CCandle/arduino_robot_XJTU/README.md

# arduino_robot_XJTU

本仓库为西安交通大学*创新与机器人创客实践*课程实践小组的开发仓库

`remote` 与 `src` 目录下分别为遥控器和机内控制程序 Arduino 项目

`DevelopingFiles` 文件内含接线图纸与软件模拟代码
