CCandle/arduino_robot_XJTU/Report/report.tex

\documentclass[a4paper]{ctexart}
\usepackage{xeCJK}

\setCJKmainfont[BoldFont={方正大黑简体}, ItalicFont={方正盛世楷书简体_准}, BoldItalicFont={方正大标宋简体}]{方正标雅宋简体}
\setCJKsansfont{方正兰亭细黑简体}
\setCJKmonofont{仿宋}

\title{配重式全向球形机器人}
\author{码力全关组}

% Math
\usepackage{amsthm, amsmath, amssymb}
\usepackage{mathrsfs}
% Utility
\usepackage{graphicx}
\usepackage{subfigure}
\usepackage{lastpage}
% Beautifying packages
\usepackage{wallpaper}
% Code related
\usepackage{minted, framed}
\usepackage{listings}
\usepackage[linesnumbered,boxed]{algorithm2e}
% Formatting
\usepackage{footmisc}
\usepackage{float}
\usepackage{longtable, array, booktabs}
\usepackage{fancyhdr}
\usepackage{tcolorbox, framed}
\usepackage{geometry}
\usepackage{multicol}
%\usepackage[toc]{multitoc}
\usepackage{hyperref}
% tikz
\usepackage{xcolor}
\usepackage{tikz}
\usetikzlibrary{arrows,shapes,chains}

\tikzstyle{startstop}=[rectangle,rounded corners,minimum width=3cm,minimum height=1cm,text centered,draw=black,fill=red!30]
\tikzstyle{process}=[rectangle,minimum width=3cm,minimum height=1cm,text centered,text width =3cm,draw=black,fill=orange!30]
\tikzstyle{arrow}=[thick,->,>=stealth]

% Macro definitions
\usepackage{color}
\definecolor{grey}{RGB}{190, 190, 190}
\geometry{a4paper,left=2.8cm,right=2.8cm,top=3.2cm,bottom=3.2cm}
\newcommand{ \upcite}[1]{\textsuperscript{\textsuperscript{\cite{#1} } }}
\newcommand{ \mathbit}[1]{\mathbf{\mathit{#1}}}
\hypersetup{
colorlinks=true,
linkcolor=black
}
\numberwithin{equation}{section}
\numberwithin{table}{section}
\numberwithin{figure}{section}

\setlength{\columnseprule}{0.8pt}
\setlength\columnsep{1cm}

%%%%%%%%%%%%%%%%%%

\begin{document}
\setboolean{@twoside}{true}

\begin{titlepage}

  \maketitle
  \begin{center}
    小组课程实践
  \end{center}

  \ThisLRCornerWallPaper{0.8}{cover.png}

  \begin{center}
  \begin{tabular}[]{cccc}
  \toprule
  成员/分工 & 班级 & 姓名 & 联系电话\\
  \midrule
  组长 & 计算机试验班91 & 张骏扬 & 18967993817 \\
  执行组长 & 电类012 & 曲凌枫 & 15698207871 \\
  机械组 & 电气与信息003 & 马博楠 & 17693108836 \\
  电子组 & 计算机试验班001 & 栾家骏 & 13323022829 \\
  软件组 & 计算机试验班91 & 戴嘉琦 & 18612535164 \\
  \bottomrule
  \end{tabular}
\end{center}
  \addtocounter{table}{-1}

\begin{center}
  创新思维和机器人创客实践
\end{center}

\thispagestyle{empty}

\end{titlepage}

\addtocounter{page}{-2}

\newpage

\thispagestyle{fancy}
\lhead{}
\chead{\it\small{\textcolor{grey}{目录}}}
\rhead{}
\cfoot{}

\tableofcontents

\newpage

% now body
\pagestyle{fancy}
\fancyhead[RE, LO]{\it\small\rightmark}
\fancyhead[C]{\small{\it\textcolor{grey}{配重式球形机器人}}}
\fancyhead[LE, RO]{\it\small{马力全关组}}
\fancyfoot[C]{\it\small{第 \thepage 页\ 共 \pageref{LastPage} 页}}

\section{问题提出}

\subsection{设计背景与目的}

本组所建立的配重式全向球形机器人项目是西安交通大学课程“创新思维和机器人创客实践”的机器人小组实践项目。设计目的是：

\begin{itemize}
  \item 进行团队组织实践，使用团队组织技巧，锻炼合作能力；
  \item 进行产品调研与开发实践，锻炼创新能力；
  \item 进行机械、电子、软件设计实践，锻炼学习与设计能力；
  \item 进行系统统调装配，锻炼排错与优化能力。
\end{itemize}

球形机器人的应用包括监视、环境监测、巡视、水下探索、行星探索、复康、儿童发展及娱乐。球形机器人也可以是可以在陆地上或是水中（或水底）行动的两栖机器人。

\subsection{国内外现有研究成果}

最常见的球形机器人行动方式是透过调整机器人的重心位置来达到\upcite{halme1996motion}。其他的行动方式有利用飞轮的角动量守恒\upcite{joshi2010design}、利用环境中的风、利用外壳形变的方式移动、以及用陀螺仪效应。

配重式全向球形机器人最初的设计概念在 2004 年被提出\upcite{2004Introducing}。

\section{需求分析}

\subsection{需求分析和筛选}

本项目拟实现的机器人分两类，一类是足式机器人，一类是球形机器人。本组最终选择了球形机器人，原因是，根据本项目锻炼设计与创新能力的目标，球形机器人应用较不成熟，有更大难度与发展空间，符合需求。

球形形态机器人可衡量的目标有以下几点：

\begin{itemize}
  \item 全向对称移动：在球形机器人的任何状态能够以任意方向继续滚动，使得在地面斜率变化的情况下可以使用算法保持稳定的运动路线；
  \item 精密控制能力：配重式球形机器人能够进行精密的位置操控；
  \item 通过性：同尺寸球形机器人相较其他形态拥有较强的通过性，适应不平整地形；
  \item 机械强度与密闭性：球形机器人可以使用无线控制方式，使得球壳能够完全密闭，防水抗干扰；
\end{itemize}

这些目标基本是可以同时达到的，但是均为设计阶段就决定的问题，并且样机一般无法做到机械强度等指标，只可能在精密控制指标下细化。这些指标考验了设计能力。

\section{设计概念生成、选择、评估与实现}

\subsection{概念的生成}

下面介绍本项目按时间阶段拟设计的四种机器人方案。

\subsubsection{设计概念一——六足式机器人}

最初，本项目拟设计制作六电机六足式模块化机器人，并使用该设想进行初步立项。该设想被否决，原因是已有成熟的商业产品先例以及开源项目，无法体现创新性。

\begin{figure}[H]
  \begin{center}
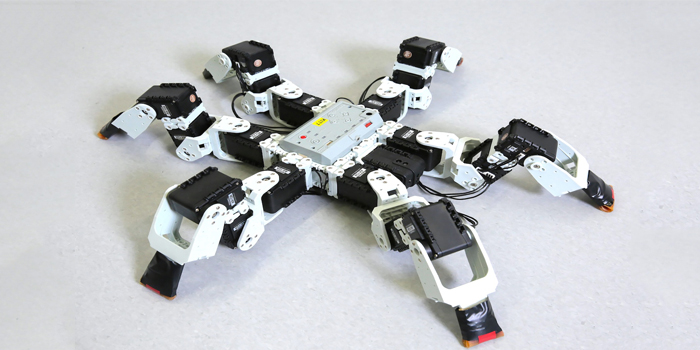
[picture p1: Report/figures/sixfeet.jpeg]
    
  \end{center}
  \label{fig_concept_1}
  \caption{设计概念目标设想图}
\end{figure}

本设计概念已经进展到查阅相关资料，尝试阅读控制逻辑的阶段。本设计概念提出尝试实行后立刻更改了设想。

\subsubsection{设计概念二——三足式弹跳机器人}

六足机器人否决后，本项目拟设计制作小型化三足式弹跳机器人。

该弹跳机器人通过电机压缩弹簧，随后释放锁止机构，使机器人进行不断运动。并通过不同的电机压缩程度控制弹跳方向。

\begin{figure}[H]
  \begin{center}
    
  \end{center}
  \label{fig_concept_2}
  \caption{设计概念二草图设计图}
\end{figure}

本设计概念已经进展到草图设想，控制系统拟设计的阶段。

然而在初步设计控制算法和电子系统后，发现短时间内的资源不足以使机器人达到轻量化，样机验证困难。因各种原因遂放弃该设计。

\subsubsection{设计概念三——重心牵拉式球形机器人}

由于三足式机器人的流产，本项目将方向转变为球形机器人。

\begin{figure}[H]
  \begin{center}
    
  \end{center}
  \label{fig_concept_3}
  \caption{设计概念三草图设计图}
\end{figure}

设计概念三是球形牵拉式配重机器人。正四面体球心的主体部分是控制结构与电机，同时作为配重改变球体的重心。四个线轴由电机控制，通过改变线的长度改变重心相对于几何中心的位置，利用重力矩使机器人运动。

该设计概念难以实现的原因是，线轴难以保证不滑动，且难以进行加工，遂否决。

\subsubsection{设计概念四——配重式球型机器人}

最终，在设计概念三的基础上，本项目设计了四组配重块形成的配重式球形机器人。具体设计见下文。

\subsection{概念选择与评估}

由上述设计概念历史，足型机器人不符合创新设计的要求，牵拉式机器人机械结构难以实现，于是选择配重式球形机器人。

\section{概念的具体设计}

\subsection{机械系统设计}

\begin{figure}[H]
  \begin{minipage}{0.32\linewidth}
    \begin{center}
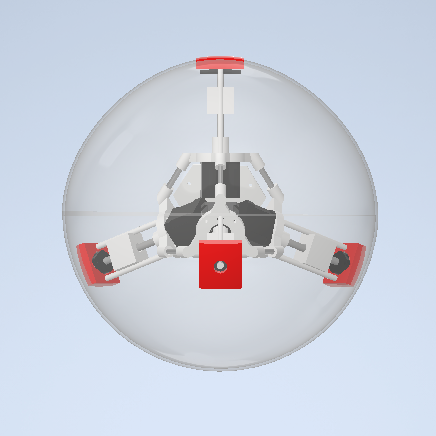
[picture p2: Report/figures/rendered1.png]
      
    \end{center}
  \end{minipage}
  \hfill
  \begin{minipage}{0.32\linewidth}
    \begin{center}
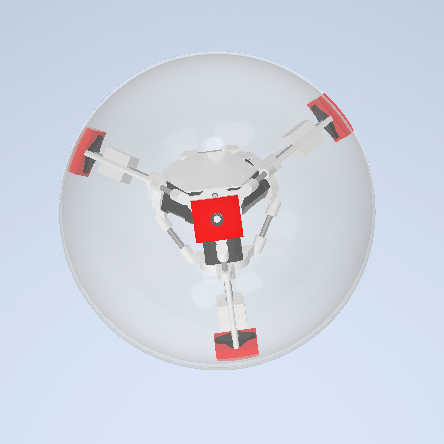
[picture p3: Report/figures/rendered2.png]
      
    \end{center}
  \end{minipage}
  \hfill
  \begin{minipage}{0.32\linewidth}
    \begin{center}
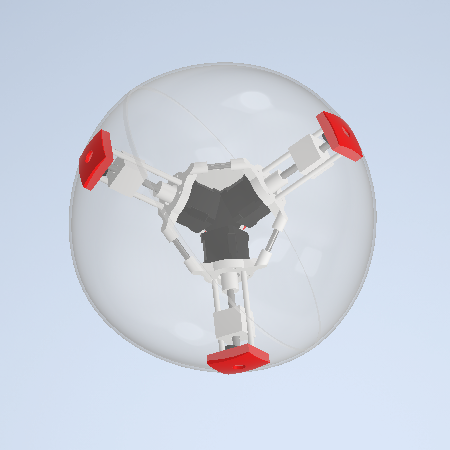
[picture p4: Report/figures/rendered3.png]
      
    \end{center}
  \end{minipage}
  \caption{机械结构 CAD 设计渲染图}
\end{figure}

该球形机器人以伊朗科技大学的 Puyan Mojabi 和伊朗加兹温阿萨德大学的 Amir Homayoun Javadi A 开发的一种全方位球形运动机器人 August\upcite{2004Introducing} 为原型进行设计，机器人主体分为核心框架，丝杆滑台，球壳三大部分。

其中核心框架为正四面体结构，四个顶角位置设计了连接角结构用于构建框架并固定步进电机。步进电机传动轴从连接角内侧身处并通过联轴器与丝杆滑台连接，滑台结构两侧的导轨在保证质量块正常运动的同时也加强了整个结构的强度。机器人内部结构通过自主设计的固定座与球壳连接，由于结构特性，连接处无需使用粘结剂固定，便于拆卸维修与调试。

机械系统各部件加工采用了不同的方法，其中注塑球壳、配重、丝杆滑台、轴承等部件为预制工业品，固定座与连接角结构框架为 3D 打印部件。电子部件的固定基座由亚克力切割完成。结构利用螺丝、无痕胶、扎带等方式固定，在保证开发效率的情况下照顾了机械强度等要求。

\subsection{电子系统设计}

\subsubsection{电子系统综述}

该机器人使用的电子系统围绕 Arduino UNO 控制板开发。图\ref{fig_elec}为遥控器系统和电子控制系统接线示意图，在实际实践中，还加入了电机电源开关等器件，便于调试与保护。

\begin{figure}[H]
  \centering
  \subfigure[机上电子系统接线图纸]{
    \label{fig_elec_subfig_a}
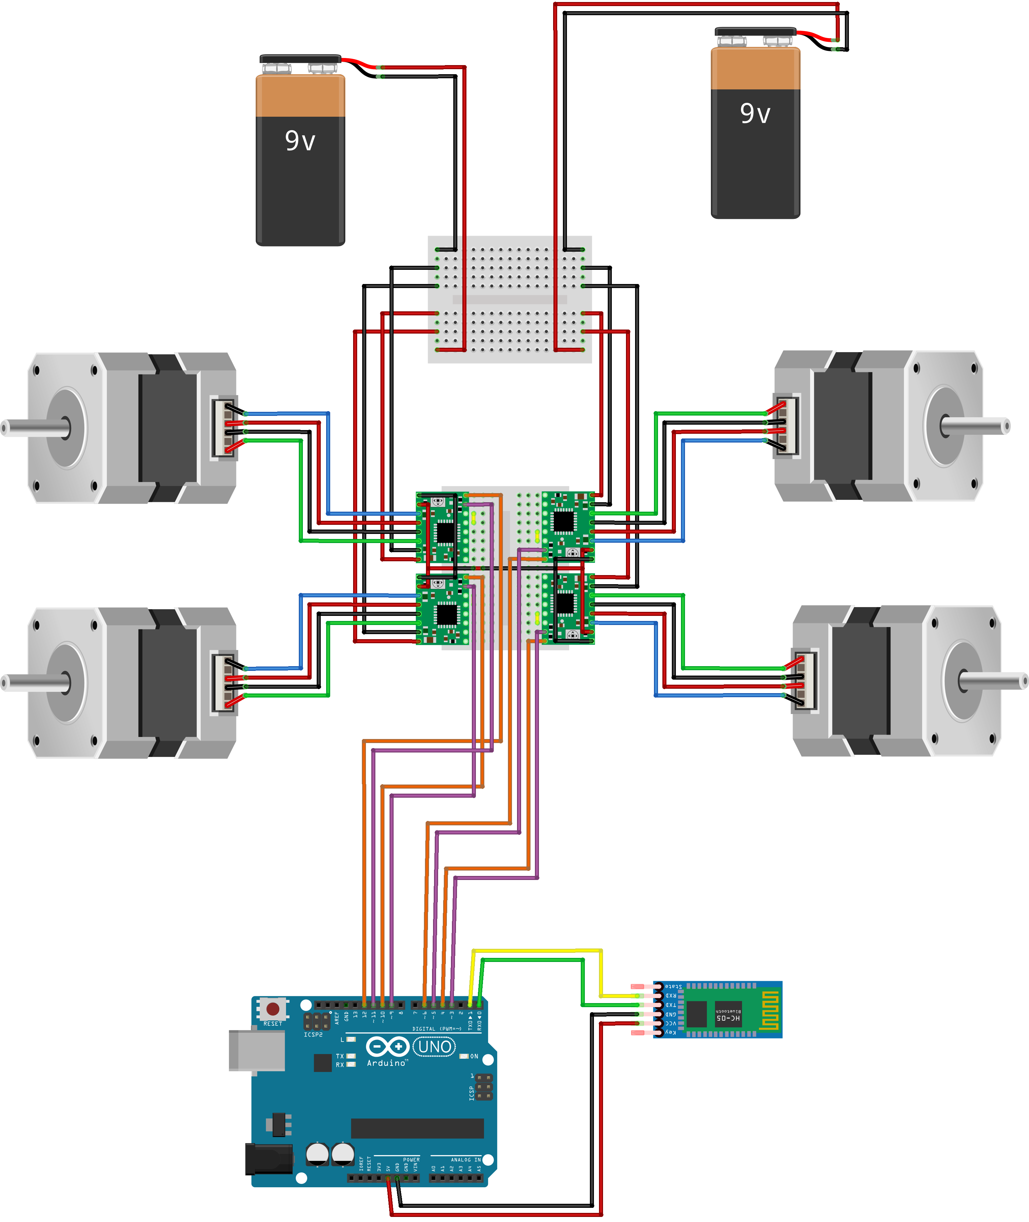
[picture p5: Report/figures/main_bb.png]
    
  }
  \hfill
  \subfigure[遥控接线图纸]{
    \label{fig_elec_subfig_b}
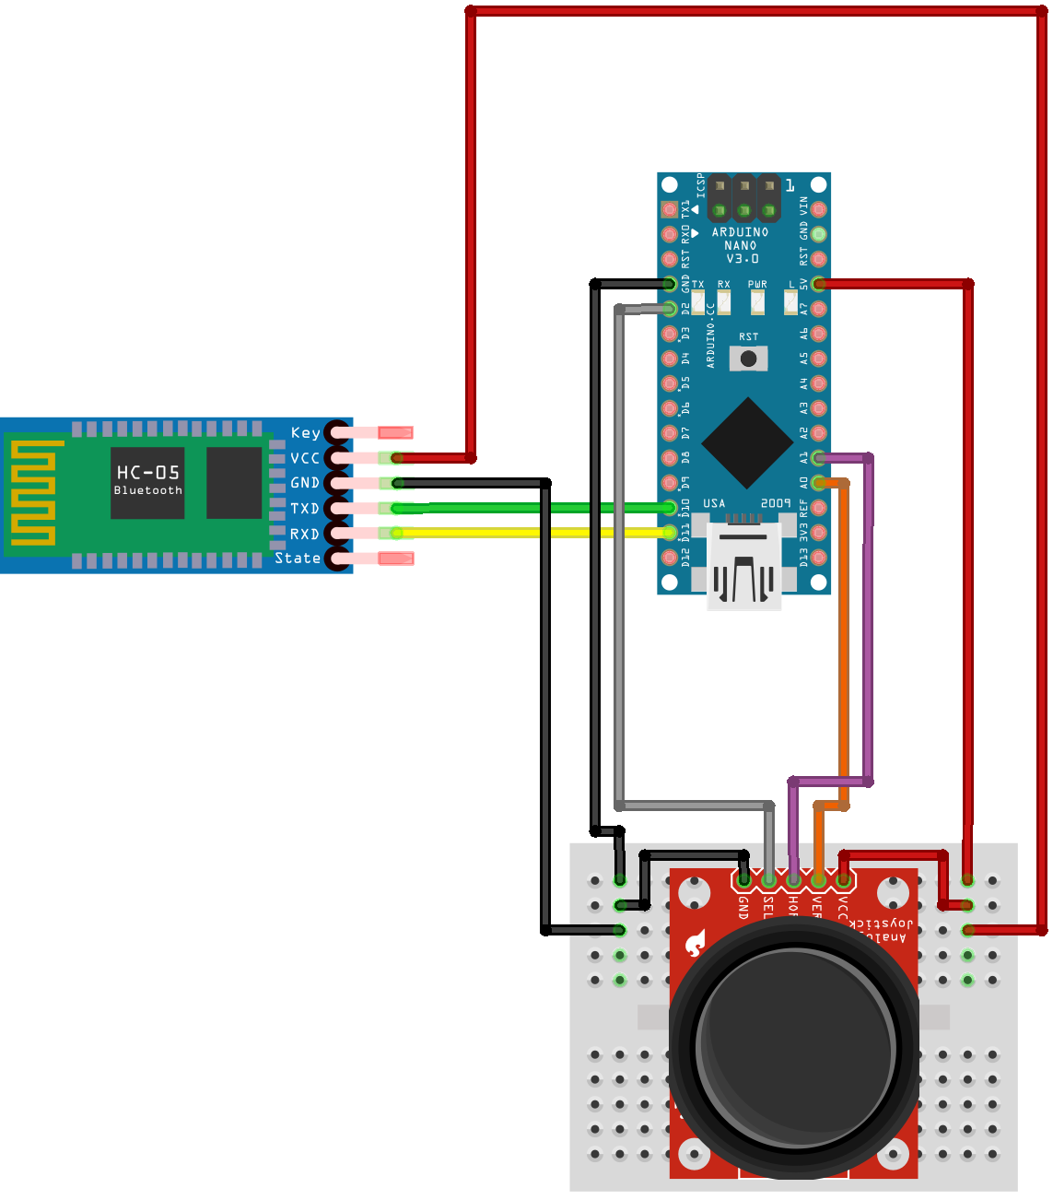
[picture p6: Report/figures/remote_bb.png]
    
  }
  \caption{电子系统图纸}
  \label{fig_elec}
\end{figure}

\subsubsection{模块接线设计}

传感器子系统采用了 MPU6050 传感器模块，其为整合性 6 轴运动处理组件，控制板通过该组件获得 pitch，roll，yaw 等姿态信息，具体线路见示意图\ref{fig_wire_subfig_a}。

\begin{figure}[H]
  \centering
  \subfigure[MPU6050 接线图纸]{
    \label{fig_wire_subfig_a}
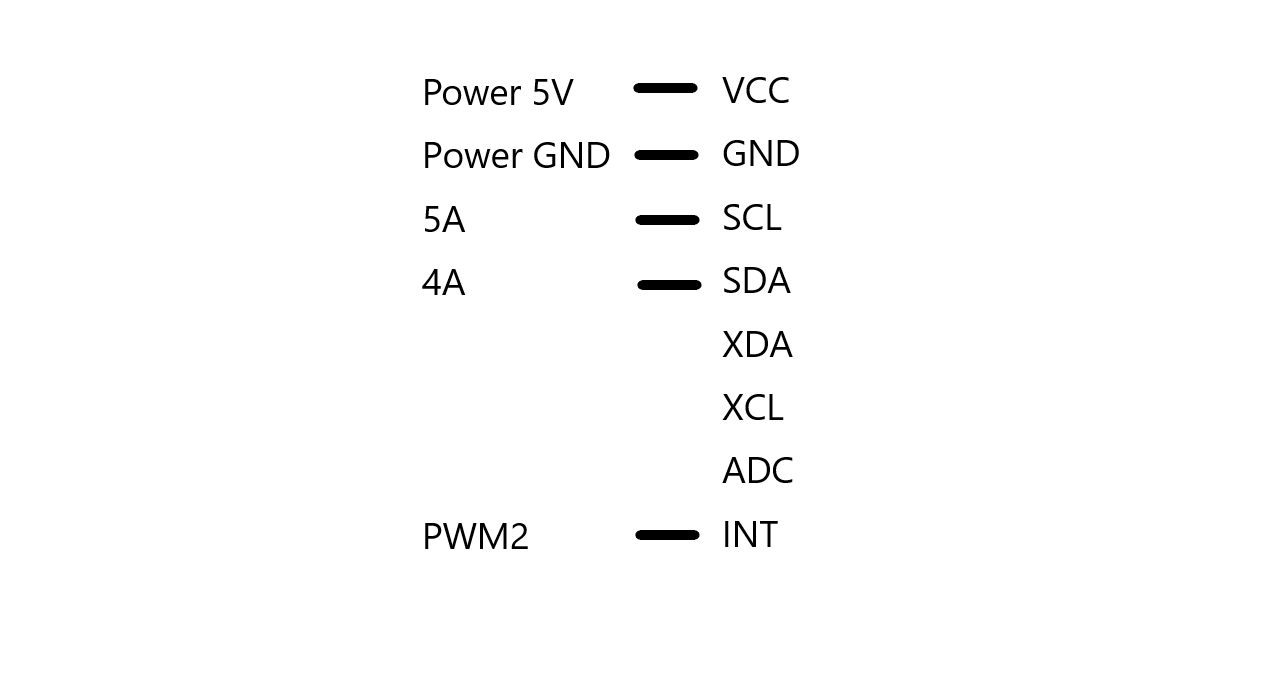
[picture p7: Report/figures/MPU6050接线图纸.png]
    
  }
  \hfill
  \subfigure[电机驱动图纸]{
    \label{fig_wire_subfig_b}
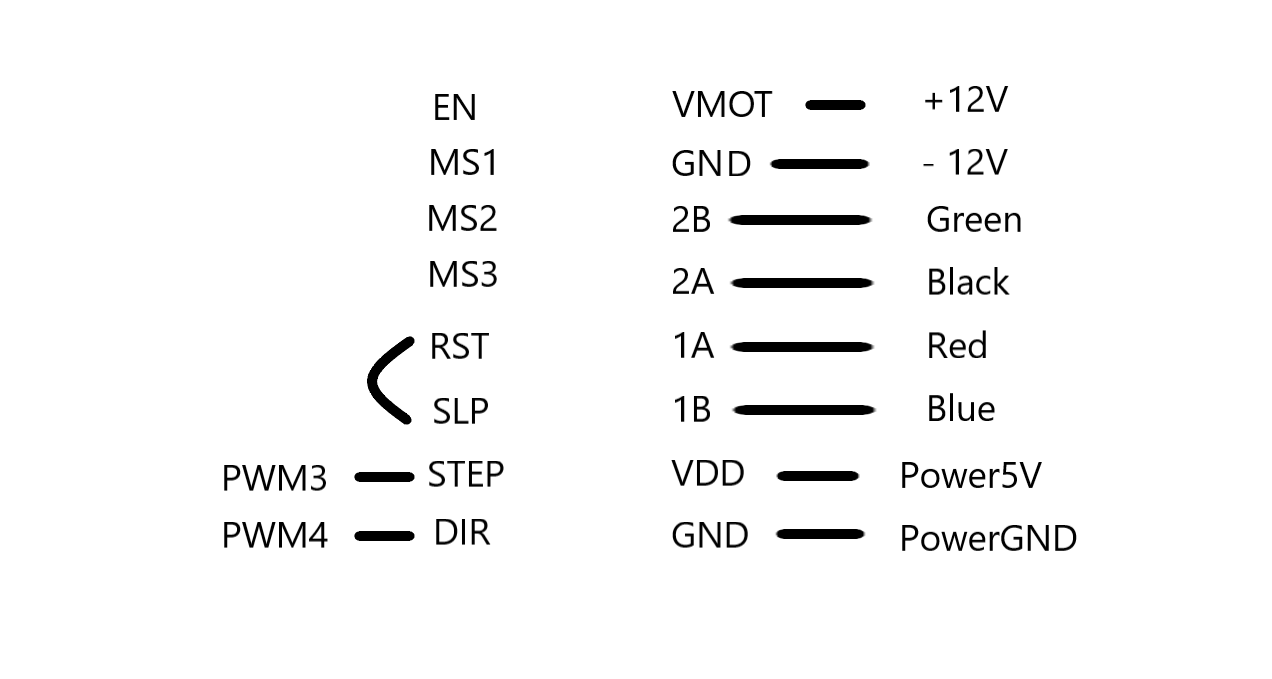
[picture p8: Report/figures/电机驱动图纸.png]
    
  }
  \caption{电子系统接线图纸}
  \label{fig_wire}
\end{figure}

步进电机子系统中，使用了 A4988 作为步进电机控制模块，示意图\ref{fig_wire_subfig_b}中，右上角的 VMOT 与 GND 提供步进电机运行电源，2B 与 2A 提供电机一极的运转电力，1B 与 1A 提供另一极；VDD 与 GND 提供 A4988 模块电力；左下 DIR（Direction）控制电机转向，STEP 控制电机旋转步数；SLP（Sleep）控制模块是否休眠，默认开启状态为高电平；RST（Reset）控制微步设置。将 SLP 与 RST 相连是为了方便进行微步设置进行调试，但实际运行中我们不采用预配置的微步操作，而是使用自己编写的一套代码控制步进电机的运转，因此在代码里我们加上了相应的函数，以调节转速、转向，并且能够控制圈数等物理参数。

\subsection{控制算法设计}

经讨论，考虑到实现可行性，本项目采用位置反馈控制而不是文献中描述的 PID 速度控制。下面简要介绍我组实现（及拟实现）的控制算法原理。

\subsubsection{坐标系统}

球形机器人依赖两种坐标系统：相对坐标系与绝对坐标系。相对坐标系是指相对于球心，方向为球壳某定点的球坐标系；绝对坐标系是指相对于地面的坐标系。在无特殊说明的情况下采用相对坐标系统。

球坐标系中，点定义为 $(\rho, \theta, \phi)$，$\rho\ge 0$ 是距离球心的位置，$\theta \in [0,2\pi)$，$\phi \in [-\pi, \pi]$ 是极角，定义为经纬弧度坐标。

球坐标到平面直角坐标的转换如下：

\begin{equation}
\begin{cases}
  x = \rho\sin\phi\cos\theta \\
  y = \rho\sin\phi\sin\theta \\
  z = \cos\phi \\
\end{cases}
\end{equation}

在该相对坐标系内，四组配重运动方向向量在直角坐标系下分别定义为：

\begin{align}
  \boldsymbol v_0 & = (0,0,R_0) \\
  \boldsymbol v_1 & = (\dfrac{2\sqrt{2}}{3}R_0,0,\dfrac{1}{3}R_0) \\
  \boldsymbol v_2 & = (-\dfrac{\sqrt{2}}{3}R_0,\dfrac{\sqrt{6}}{3}R_0,-\dfrac{1}{3}R_0) \\
  \boldsymbol v_3 & = (-\dfrac{\sqrt{2}}{3}R_0,-\dfrac{\sqrt{6}}{3}R_0,-\dfrac{1}{3}R_0)
\end{align}

我们将机器人配重块所处位置的状态定义为移动至上限 $u\boldsymbol v_i$ 与下限 $l\boldsymbol v_i$ 之间的比例 $p_i\in[0,1]$，$i = 0,1,2,3$。设单个配重块质量为 $m$，机器人除配重块外的质量为 $M$，则有机器人重心位置 $\boldsymbol c$：

\begin{equation}
  \boldsymbol c = \frac{\sum_i m [l + (u-l) p_i] \boldsymbol v_i}{M + 4m} = \frac{m (u-l)}{M + 4m}\sum_i p_i \boldsymbol v_i \triangleq C \sum_i p_i \boldsymbol v_i
  \label{equ_center}
\end{equation}

其中常量 $C=\dfrac{m (u-l)}{M + 4m}$，以下规定 $\overline{\boldsymbol c} = \dfrac{\boldsymbol c}{C} = \sum_i p_i \boldsymbol v_i$

\subsubsection{位置求解}

当机器人在低速情况时，可假设中心与重心的射线始终指向地心，也就是说，只要改变机器人重心在相对坐标系中的位置，产生滚动，就可以改变机器人中心在绝对坐标系中的位置，并且位置是确定的。下文给出一种确定性连续求解位置的方法，目的是把机器人位移指令转换的重心位置串，继续转换为配重块位置串。

\begin{figure}[H]
  \begin{minipage}{0.32\linewidth}
    \begin{center}
      
    \end{center}
  \end{minipage}
  \hfill
  \begin{minipage}{0.32\linewidth}
    \begin{center}
      
    \end{center}
  \end{minipage}
  \hfill
  \begin{minipage}{0.32\linewidth}
    \begin{center}
      
    \end{center}
  \end{minipage}
  \vfill
  \begin{minipage}{0.32\linewidth}
    \begin{center}
      
    \end{center}
  \end{minipage}
  \hfill
  \begin{minipage}{0.32\linewidth}
    \begin{center}
      
    \end{center}
  \end{minipage}
  \hfill
  \begin{minipage}{0.32\linewidth}
    \begin{center}
      
    \end{center}
  \end{minipage}
  \caption{重心位置反解的可视化计算机模拟}
\end{figure}

当给定中心位置 $\overline{\boldsymbol c}$，因式\ref{equ_center}是超定方程，拥有多解，不能立刻求出四个配重位移比例。则以电机对称调用、尽量靠近杆中心为目标，给出一个合理的求解方法。若忽略 $\boldsymbol v_3$，由于 $\boldsymbol v_0,\boldsymbol v_1,\boldsymbol v_2$ 正交，以此三个向量作为基向量，可解出 $\overline{\boldsymbol c}$ 的分解 $\left(p_0^{(3)},p_1^{(3)},p_2^{(3)}\right)$。又有 $\boldsymbol v_3 = - \boldsymbol v_0 -\boldsymbol v_1-\boldsymbol v_2$，则可以得到一个尽量靠近杆中心的非对称解：

\begin{equation}
  \left(p_0^{(3)} +\frac{1}{2}, p_1^{(3)} +\frac{1}{2}, p_2^{(3)} + \frac{1}{2}, \frac{1}{2}\right)
\end{equation}

同理，我们可以解出 $\left(p_0^{(2)},p_1^{(2)},p_3^{(2)}\right)$，$\left(p_0^{(1)},p_2^{(1)},p_3^{(1)}\right)$，$\left(p_1^{(0)},p_2^{(0)},p_3^{(0)}\right)$，将非对称解平均，即可得到一个对称解：

\begin{equation}
  \left(
    \frac{p_0^{(1)}+p_0^{(2)}+p_0^{(3)}}{4} +\frac{1}{2},
    \frac{p_1^{(0)}+p_1^{(2)}+p_1^{(3)}}{4} +\frac{1}{2},
    \frac{p_2^{(0)}+p_2^{(1)}+p_2^{(3)}}{4} +\frac{1}{2},
    \frac{p_3^{(0)}+p_3^{(1)}+p_3^{(2)}}{4} +\frac{1}{2}
  \right)
\end{equation}

由向量内积，有 $p_i^{(j)} = \overline{\boldsymbol c} \cdot \boldsymbol v_i$，也可通过线性方程组
\ref{equ_linear_solve}求解。

\begin{equation}
  \begin{bmatrix}
    \boldsymbol v_{i_0} \\
    \boldsymbol v_{i_1} \\
    \boldsymbol v_{i_2} \\
  \end{bmatrix}
  \begin{bmatrix}
    p_{i_0}^{(i_3)} \\
    p_{i_1}^{(i_3)} \\
    p_{i_2}^{(i_3)} \\
  \end{bmatrix}
  =
  \overline{\boldsymbol c}
  \label{equ_linear_solve}
\end{equation}

其中 $i_0\neq i_1\neq i_2\neq i_3$。

\subsubsection{运动方向与大地坐标}

由于相对坐标与绝对坐标不平行，在算法描述机器人状态时，除了相对坐标下的重心方向 $\overline{\boldsymbol c}$，还需要相对坐标下的前进方向 $\boldsymbol d$，其有两种实现方法，第一种是基于传感器获得绝对坐标；另一种是通过微分获得相对坐标的前进方向，定义为 $\boldsymbol d=\dfrac{\mathrm d\boldsymbol c}{\mathrm d t}$。本项目由于时间限制，暂时采用微分方式，其实现为有限差分。

当传入改变前进方向的指令时，首先由摇杆信息 $(a,b)$ 转换为平面极坐标 $\theta \in [-pi,pi)$，则需要使 $\boldsymbol d$ 沿轴 $\overline{\boldsymbol c}$ 旋转角度 $\theta$，设平面直角坐标下 $\boldsymbol d=(x,y,z)$，$\overline{\boldsymbol c}=(u,v,w)$，有旋转方程：

\begin{equation}
  \begin{bmatrix}
    x^{(n+1)} \\
    y^{(n+1)} \\
    z^{(n+1)} \\
    1
  \end{bmatrix}
  =
  \begin{bmatrix}
    u^2+(1-u^2)\cos\theta & uv(1-\cos\theta)-w\sin\theta & uw(1-\cos\theta)+v\sin\theta & 0\\
    uv(1-\cos\theta)+w\sin\theta & v^2+(1-v^2)\cos\theta & vw(1-\cos\theta)-u\sin\theta & 0\\
    uw(1-\cos\theta)-v\sin\theta & vw(1-\cos\theta)+u\sin\theta & w^2+(1-w^2)\cos\theta & 0\\
    0 & 0 & 0 & 1
  \end{bmatrix}
  \begin{bmatrix}
    x^{(n)} \\
    y^{(n)} \\
    z^{(n)} \\
    1
  \end{bmatrix}
\end{equation}

此时若有控制指令序列 $\{(a_i,b_i)\}$，即可得到位置序列 $\{\overline{\boldsymbol c}_i\}$ 与方向序列 $\{\boldsymbol d_i\}$，有 $\overline{\boldsymbol c}_i = \overline{\boldsymbol c}_{i-1} + v\boldsymbol d_i$，其中 $v$ 为输入速度。综上即可完成机器人的指令控制。

\section{概念原型化和实践总结}

\subsection{概念的原型化结果}

本项目已完成样机的开发，并且进行了控制算法的上机调试。然而，由于没有足够时间对接参数与进一步详细开发，球的运动性能较差，机械部分出现配重滑动等现象，需要软件校准，并且需要完成传感器矫正系统的开发。总体项目进度为 80\%。

\begin{figure}[H]
  \begin{center}
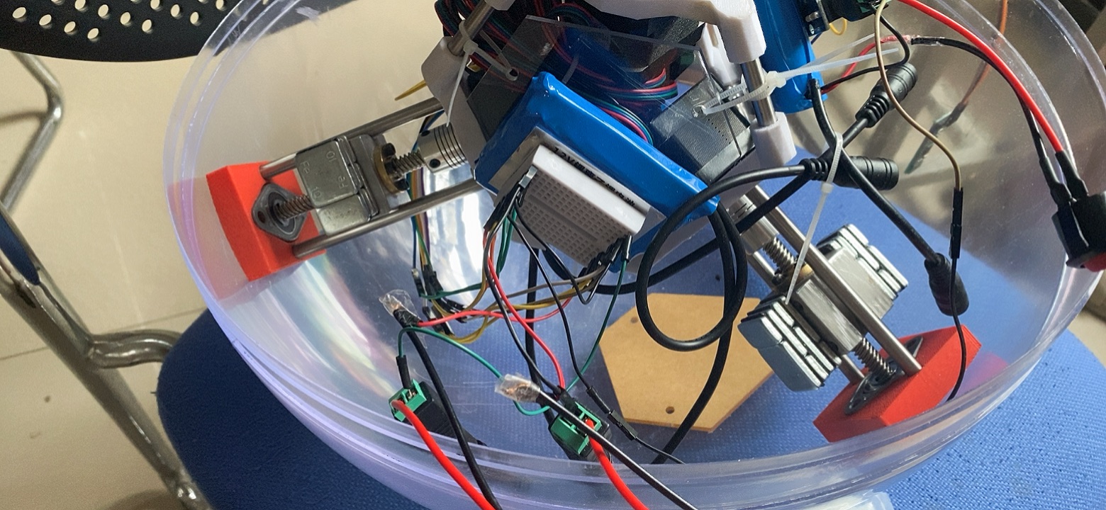
[picture p9: Report/figures/result1.png]
    
  \end{center}
  \caption{样机细节图}
\end{figure}

本项目有希望进一步进行开发，完成控制和精准控制系统的研发和实现。

\begin{figure}[H]
  \begin{center}
    
  \end{center}
  \caption{项目人员合照}
\end{figure}

\subsection{创新实践总结}

本项目的研发工作在半个学期内达到了中后期阶段，这一切成绩均离不开各位组员的积极参与与勤奋付出。

机械设计与加工部分由马博楠同学完成；电子部分中，整体系统由曲凌枫同学设计组件，传感器子系统与电机子系统由栾家骏负责组装调试；软件部分中，控制算法由张骏扬同学开发完成，模块通信部分由戴嘉琦开发完成。各成员也参与到了其他成员的活动中，完成了模块函数的封装，控制算法的讨论，通信协议的确定，机械参数的对接等工作。

本项目软件部分多数成果使用 Git（分布式版本管理工具）维护，可以作为项目整体进度的参考。

\begin{figure}[H]
  \begin{minipage}{0.98\linewidth}
    \begin{center}
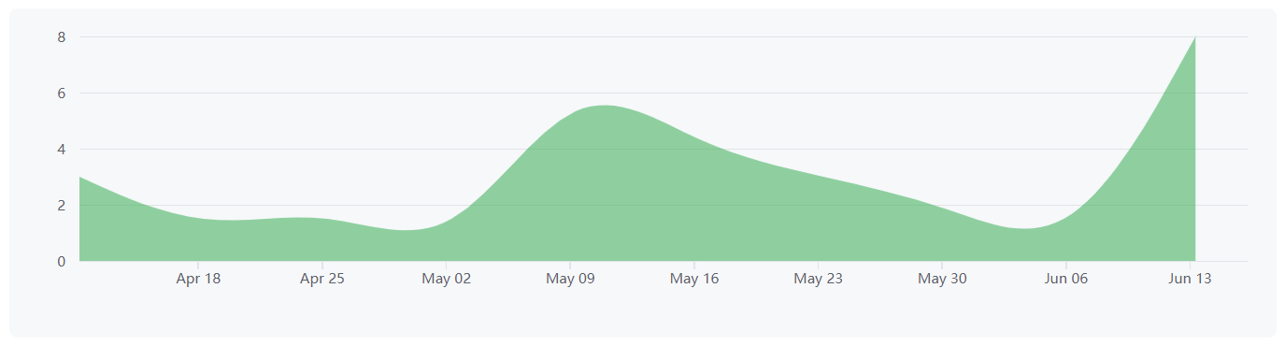
[picture p10: Report/figures/github.png]
      
    \end{center}
  \end{minipage}
  \vfill
  \begin{minipage}{0.98\linewidth}
    \begin{center}
      
    \end{center}
  \end{minipage}
  \caption{Git Commit 历史与分支网络}
\end{figure}

各组员在这一次实践中可谓是收获满满，学习了平时没有机会接触到的跨领域的开发能力，也在忙碌之中体验了标准化团队合作流程。在此再次感谢提供引导、支持、帮助的课程老师及助教！

\newpage
\thispagestyle{fancy}
\lhead{}
\chead{\it\small{\textcolor{grey}{参考文献}}}
\rhead{}
\fancyfoot[C]{\it\small{第 \thepage 页\ 共 \pageref{LastPage} 页}}
\phantomsection
\addcontentsline{toc}{section}{参考文献}
\bibliography{mycitation}
\bibliographystyle{gbt7714-2005}
%\printbibliography

\end{document}
