CCandle/arduino_robot_XJTU/Report/cover.png

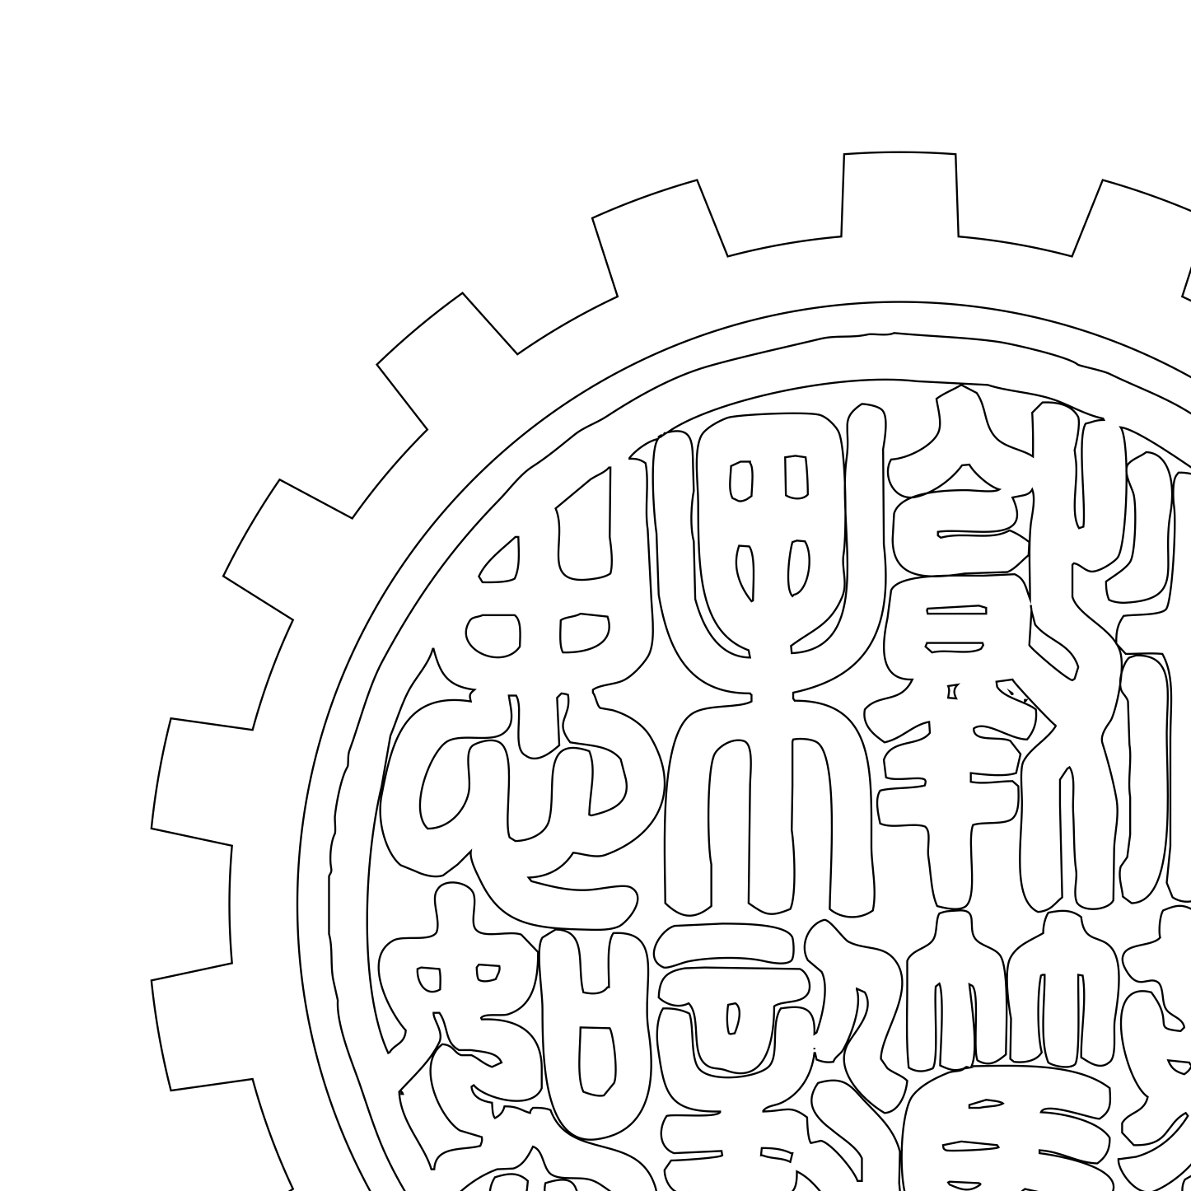
Report/cover.png
