CCandle/arduino_robot_XJTU/(commit log)

2021-04-15 started arduino coding
2021-05-29 Structure rebuilt for arduino
2021-06-16 added wiring figures
